joeelbeltagy-rgb/DC-Variable-Power-Supply-/(list of files, drawings)

Other design files:
simulation/power_circuit.pdsprj
