joeelbeltagy-rgb/DC-Variable-Power-Supply-/(commit log)

2026-06-04 Initial commit: Variable DC Power Supply project
2026-06-04 Add circuit schematic and Proteus simulation file
    [power_circuit.pdsprj]
2026-06-04 Add Arduino source code and update README with code section
2026-06-04 Add Arduino source code matching LCD display output
